CosminGeorge30/Stabilizator-de-tensiune-cu-element-de-reglaj-serie/poza_design_pcb.jpg

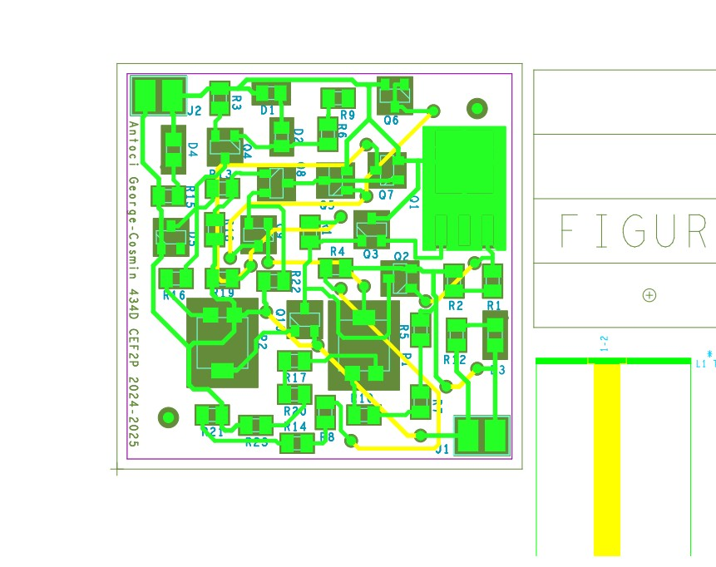
poza_design_pcb.jpg
