CosminGeorge30/Stabilizator-de-tensiune-cu-element-de-reglaj-serie/Simulations/top_pcb.jpg

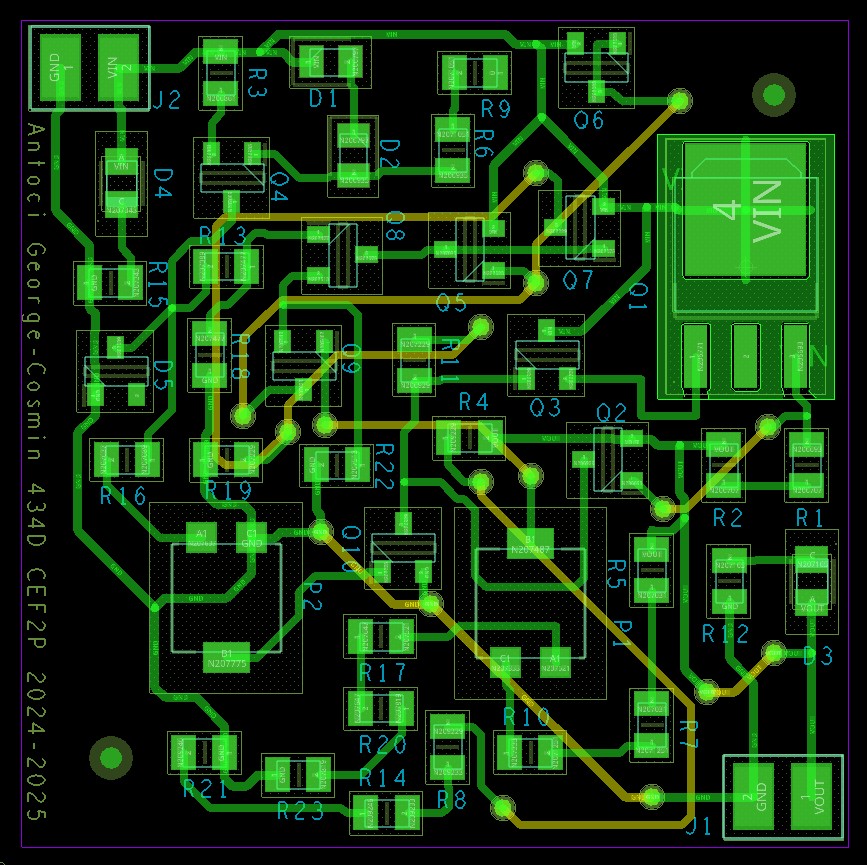
Simulations/top_pcb.jpg
