CosminGeorge30/Stabilizator-de-tensiune-cu-element-de-reglaj-serie/Proiect_docs/psf.pdf

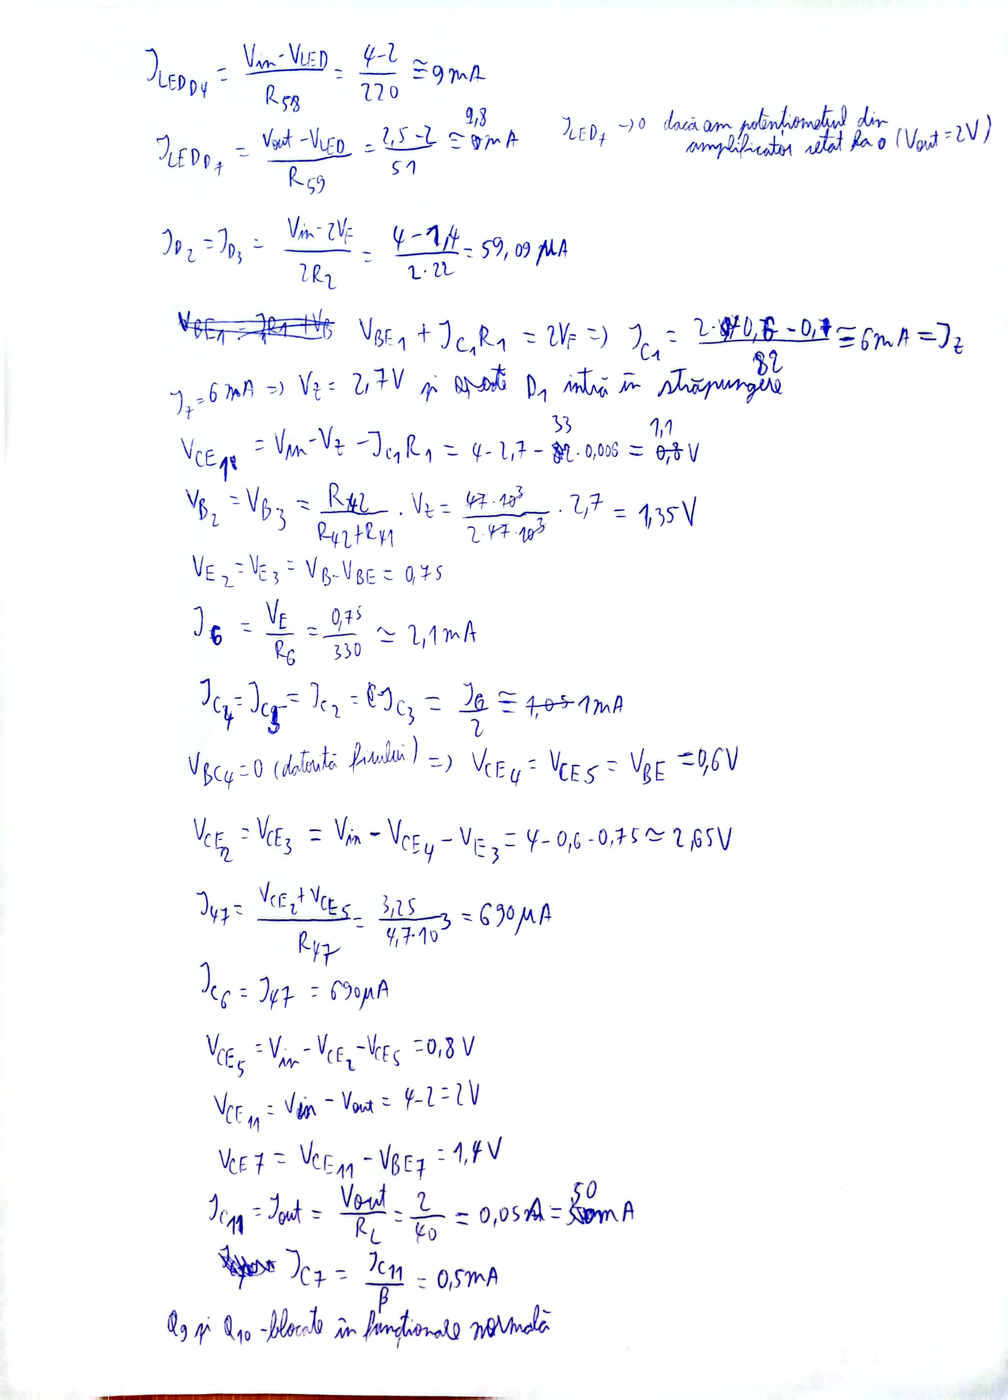
[picture p25: page 1]
