CosminGeorge30/Stabilizator-de-tensiune-cu-element-de-reglaj-serie/P1_Circuit_SERS/SERS_N1.png

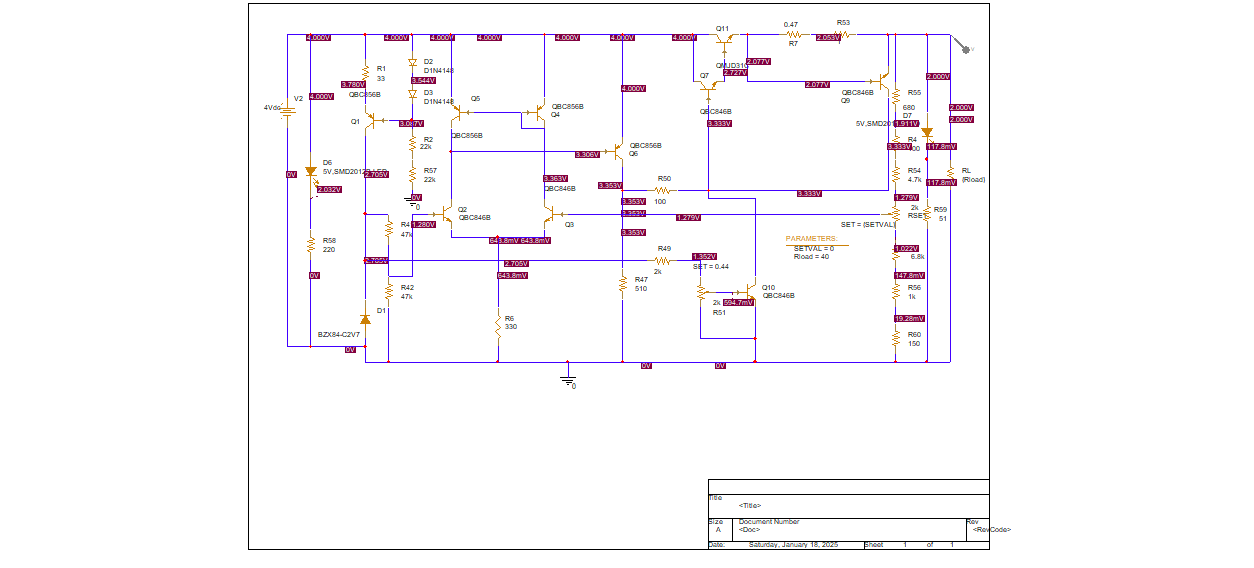
P1_Circuit_SERS/SERS_N1.png
