CosminGeorge30/Stabilizator-de-tensiune-cu-element-de-reglaj-serie/P1_Circuit_SERS_PCB/P1_PCB.png

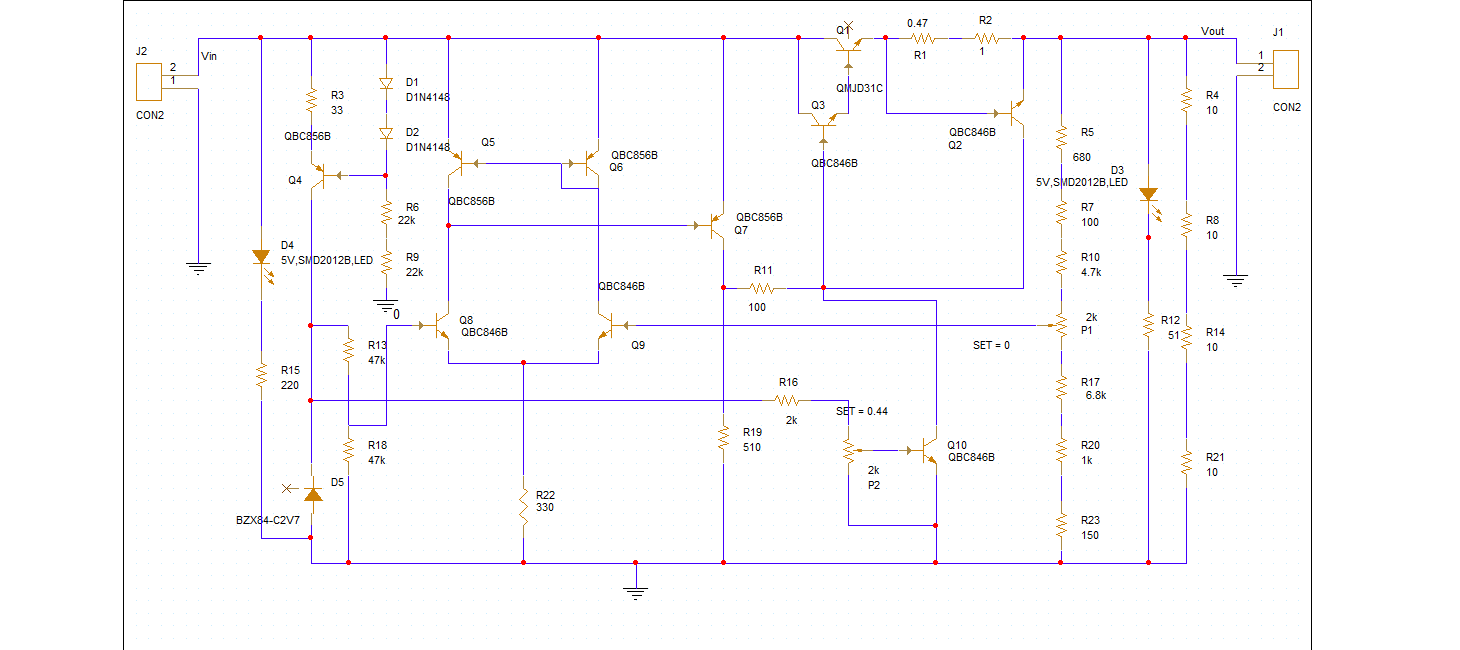
P1_Circuit_SERS_PCB/P1_PCB.png
