CosminGeorge30/Stabilizator-de-tensiune-cu-element-de-reglaj-serie/Schema_bloc.jpg

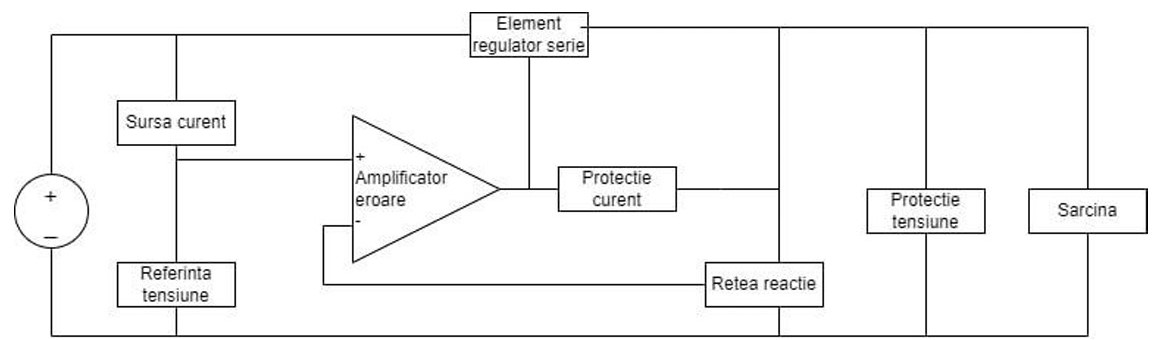
Schema_bloc.jpg
