CosminGeorge30/Stabilizator-de-tensiune-cu-element-de-reglaj-serie/Simulations/protectie_suprasarcina.jpg

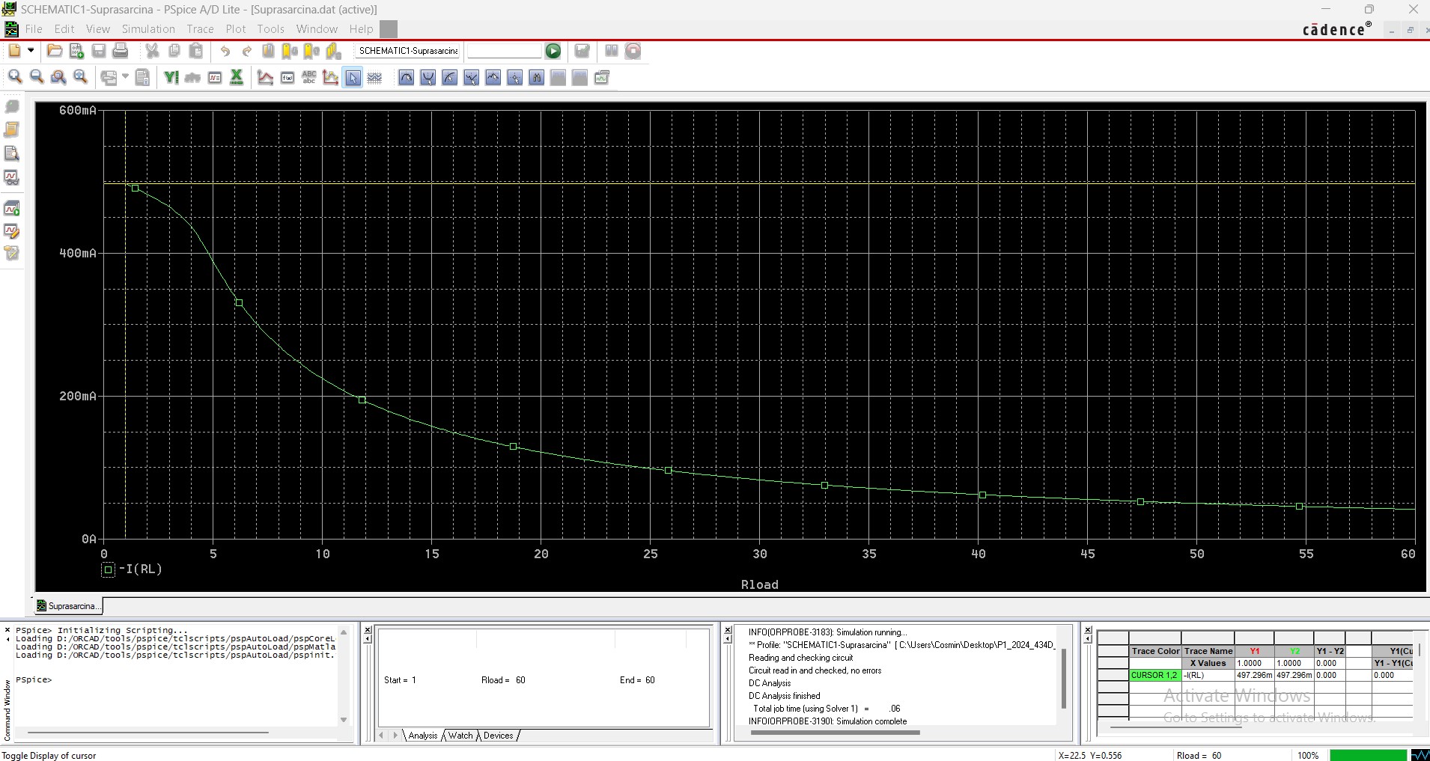
Simulations/protectie_suprasarcina.jpg
