CosminGeorge30/Stabilizator-de-tensiune-cu-element-de-reglaj-serie/Simulations/Vout_in_functie_de_set_potentiometru.jpg

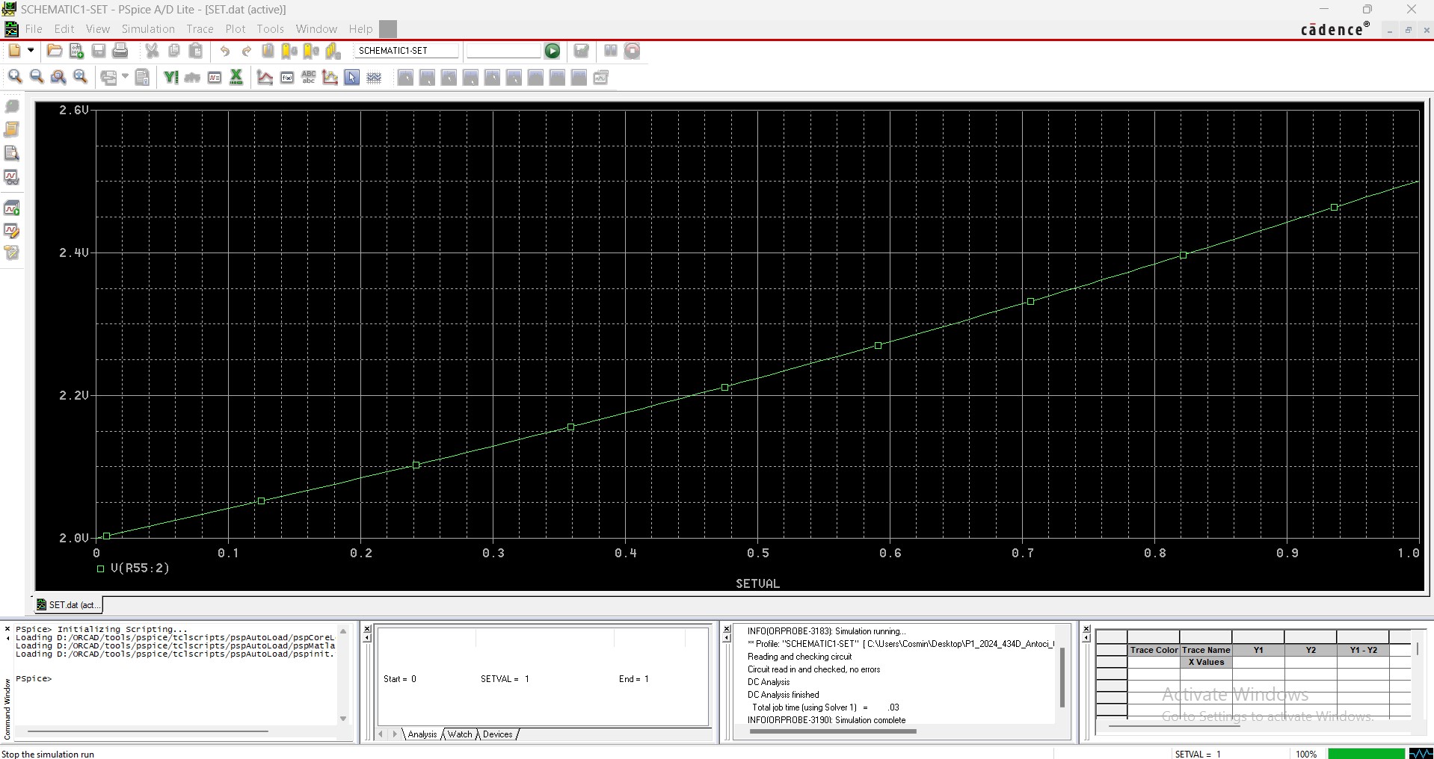
Simulations/Vout_in_functie_de_set_potentiometru.jpg
