CosminGeorge30/Stabilizator-de-tensiune-cu-element-de-reglaj-serie/Simulations/Vout_in_functie_de_Vin.jpg

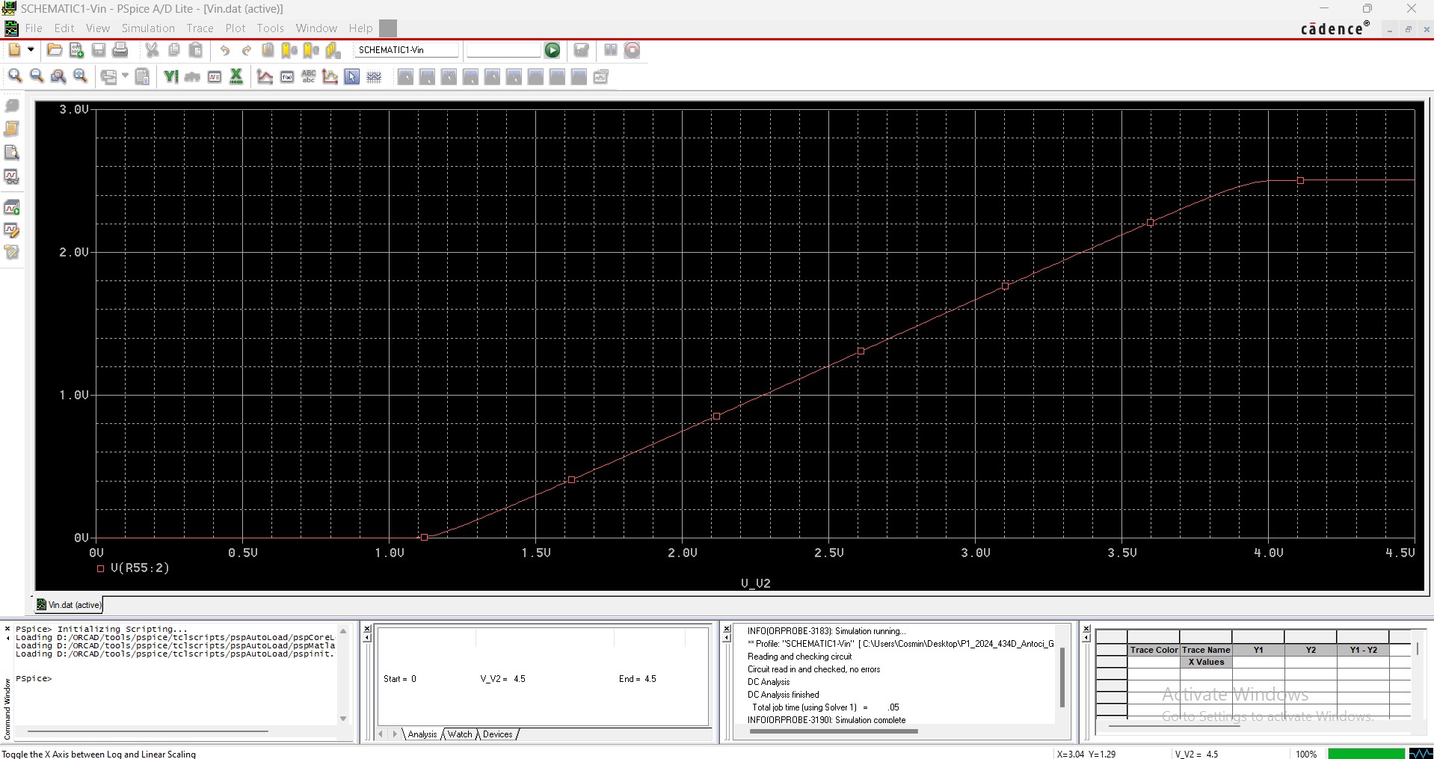
Simulations/Vout_in_functie_de_Vin.jpg
