CosminGeorge30/Stabilizator-de-tensiune-cu-element-de-reglaj-serie/P1_Circuit_SERS_PCB/ZL301-40P.stp

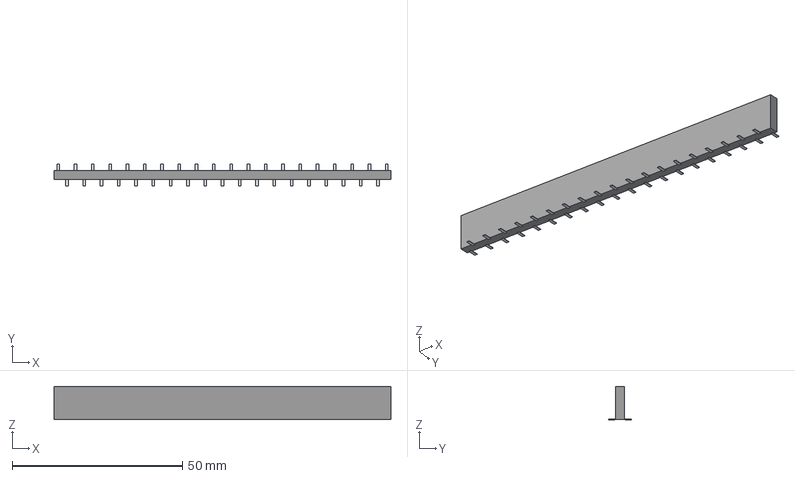
[picture p32: CAD file, 2025-03-30]
P1_Circuit_SERS_PCB/ZL301-40P.stp
99.1 x 6.50 x 9.80 mm
Pins
