CosminGeorge30/Stabilizator-de-tensiune-cu-element-de-reglaj-serie/P1_Circuit_SERS_PCB/CD4148WS_0805C_.stp

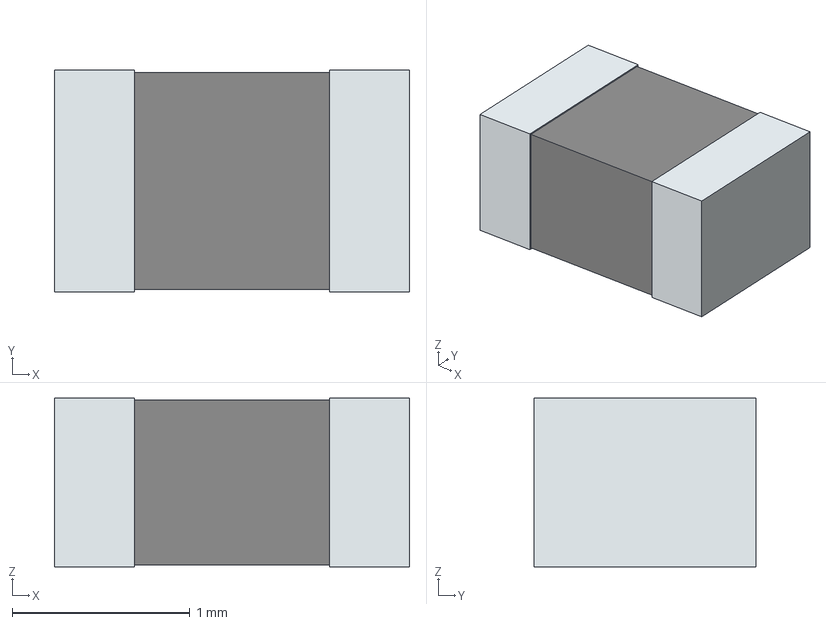
[picture p33: CAD file, 2025-03-30]
P1_Circuit_SERS_PCB/CD4148WS_0805C_.stp
2.00 x 1.25 x 0.95 mm
term1
term2
