CosminGeorge30/Stabilizator-de-tensiune-cu-element-de-reglaj-serie/P1_Circuit_SERS_PCB/res.stp

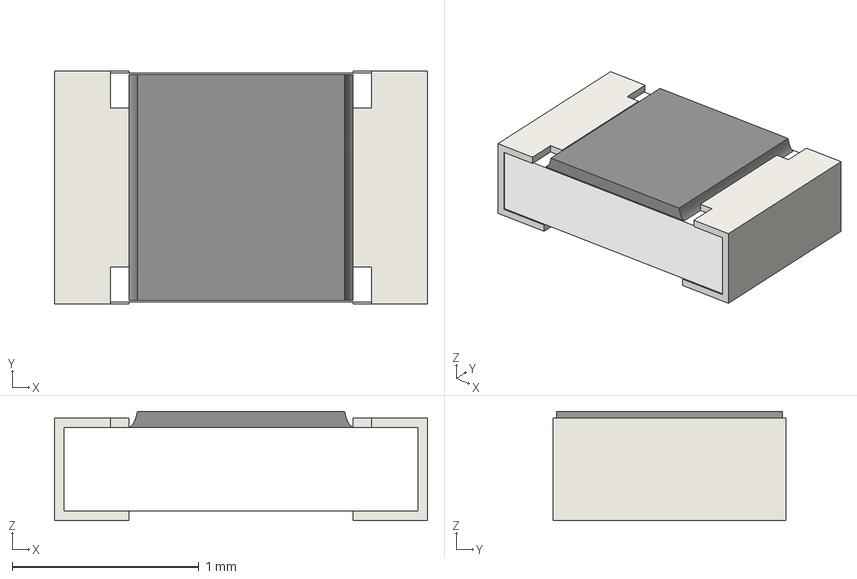
[picture p34: CAD file, 2025-03-30]
P1_Circuit_SERS_PCB/res.stp
2.00 x 1.25 x 0.585 mm
