CosminGeorge30/Stabilizator-de-tensiune-cu-element-de-reglaj-serie/P1_Circuit_SERS_PCB/BC846B.stp

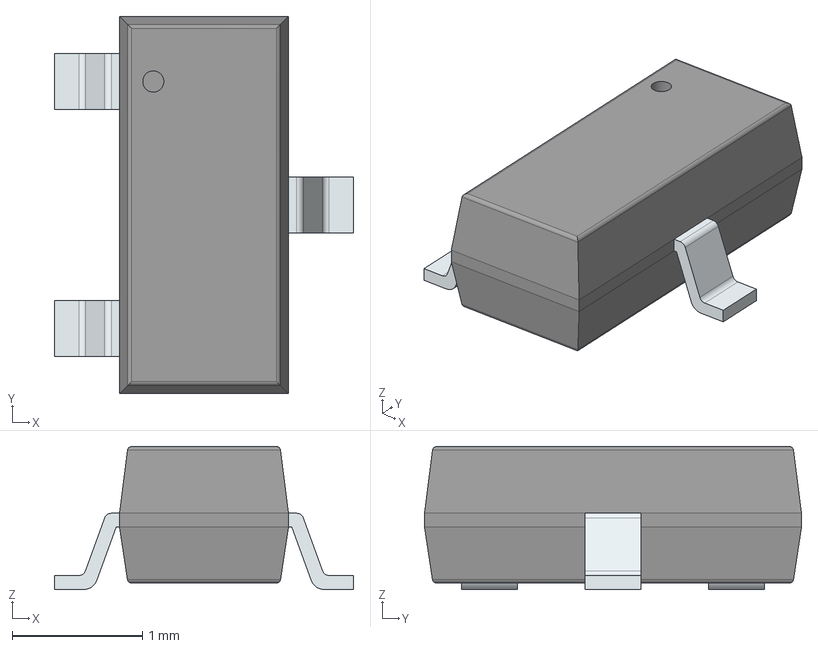
[picture p35: CAD file, 2025-03-30]
P1_Circuit_SERS_PCB/BC846B.stp
2.30 x 2.90 x 1.10 mm
PinsArrayL
FilletPinR
