CosminGeorge30/Stabilizator-de-tensiune-cu-element-de-reglaj-serie/P1_Circuit_SERS_PCB/3314G-1-103E.stp

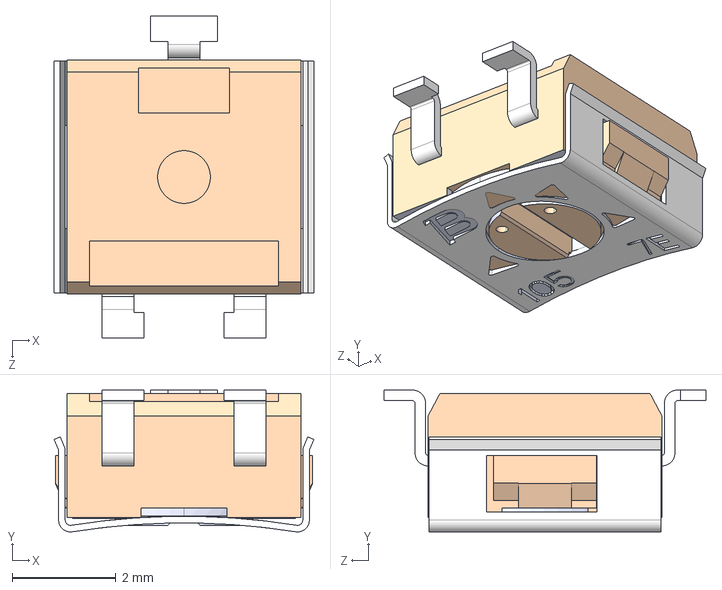
[picture p36: CAD file, 2025-03-30]
P1_Circuit_SERS_PCB/3314G-1-103E.stp
5.00 x 2.73 x 6.20 mm
