CosminGeorge30/Stabilizator-de-tensiune-cu-element-de-reglaj-serie/P1_Circuit_SERS_PCB/MJD31CG.stp

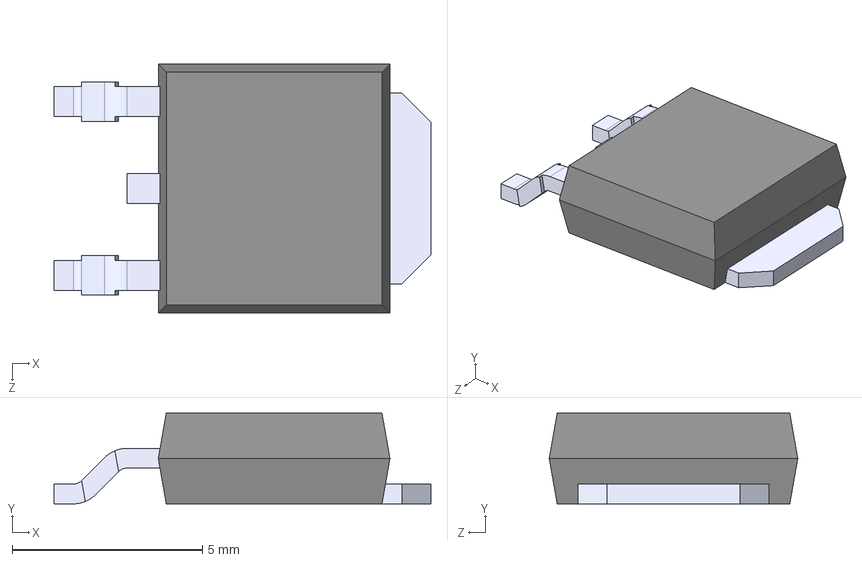
[picture p37: CAD file, 2025-03-30]
P1_Circuit_SERS_PCB/MJD31CG.stp
9.92 x 2.39 x 6.54 mm
MAC4DCMT4G_5
MAC4DCMT4G
MAC4DCMT4G_4
MAC4DCMT4G_3
MAC4DCMT4G_2
