CosminGeorge30/Stabilizator-de-tensiune-cu-element-de-reglaj-serie/P1_Circuit_SERS_PCB/OF-SMD2012B.stp

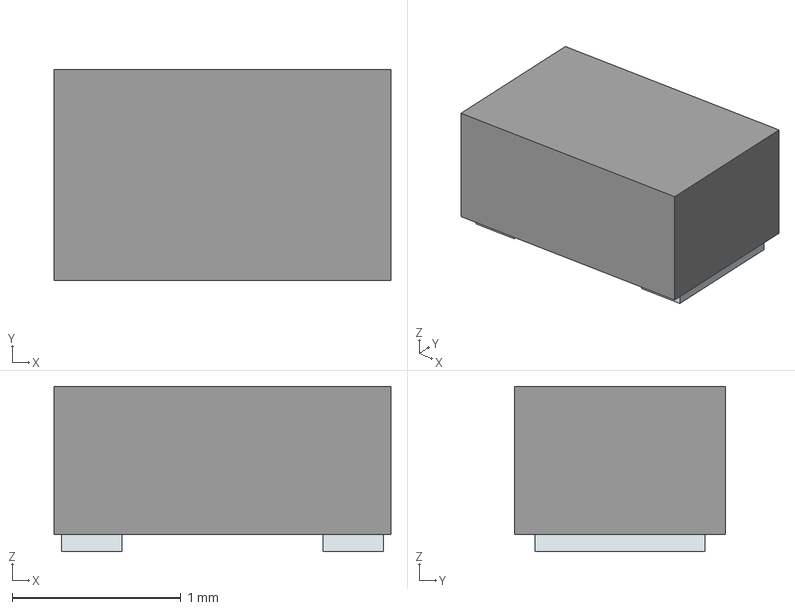
[picture p38: CAD file, 2025-03-30]
P1_Circuit_SERS_PCB/OF-SMD2012B.stp
2.00 x 1.25 x 0.98 mm
Pins
