CosminGeorge30/Stabilizator-de-tensiune-cu-element-de-reglaj-serie/P1_Circuit_SERS_PCB/TS53YL202MR10.stp

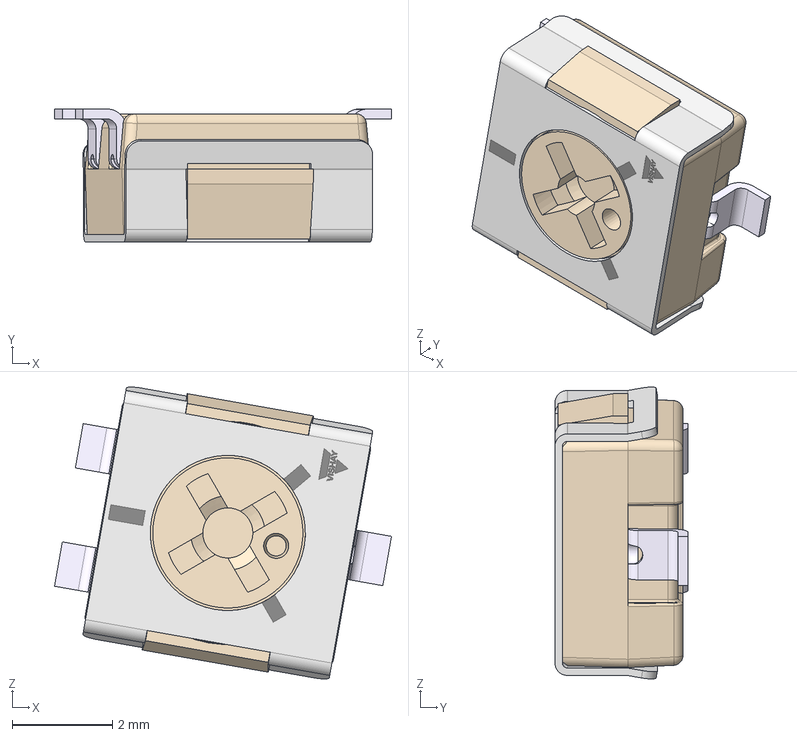
[picture p39: CAD file, 2025-03-30]
P1_Circuit_SERS_PCB/TS53YL202MR10.stp
6.73 x 2.66 x 5.83 mm
substrat seul
3935201-L
