CosminGeorge30/Stabilizator-de-tensiune-cu-element-de-reglaj-serie/(list of files, drawings)

Other design files:
Lib_ModelePSpice_Anexa_1/Modele_A1_lib/1N4148.OLB
Lib_ModelePSpice_Anexa_1/Modele_A1_lib/1n4148.opj
Lib_ModelePSpice_Anexa_1/Modele_A1_lib/BC807-25.OLB
Lib_ModelePSpice_Anexa_1/Modele_A1_lib/bc807-25.opj
Lib_ModelePSpice_Anexa_1/Modele_A1_lib/BC817-25.OLB
Lib_ModelePSpice_Anexa_1/Modele_A1_lib/bc817-25.opj
Lib_ModelePSpice_Anexa_1/Modele_A1_lib/BC846B.OLB
Lib_ModelePSpice_Anexa_1/Modele_A1_lib/BC856B.OLB
Lib_ModelePSpice_Anexa_1/Modele_A1_lib/BZX84C2V7.OLB
Lib_ModelePSpice_Anexa_1/Modele_A1_lib/BZX84C5V1.OLB
Lib_ModelePSpice_Anexa_1/Modele_A1_lib/BZX84C5V6.OLB
Lib_ModelePSpice_Anexa_1/Modele_A1_lib/BZX84C6V2.OLB
Lib_ModelePSpice_Anexa_1/Modele_A1_lib/BZX84C6V8.OLB
Lib_ModelePSpice_Anexa_1/Modele_A1_lib/BZX84C10.OLB
Lib_ModelePSpice_Anexa_1/Modele_A1_lib/IRFR120NPBF.OLB
Lib_ModelePSpice_Anexa_1/Modele_A1_lib/MJD31CG.OLB
Lib_ModelePSpice_Anexa_1/Modele_A1_lib/MJD32CG.OLB
Lib_ModelePSpice_Anexa_1/Modele_A1_lib/MMBFJ177LT1G.OLB
Lib_ModelePSpice_Anexa_1/Modele_A1_lib/MMBFJ309LT1G.OLB
P1_Circuit_SERS/SERS_N1.DSN
P1_Circuit_SERS/SERS_N1.opj
P1_Circuit_SERS/SIMULARE_BUCLA_DESCHISA.DSN
P1_Circuit_SERS/Simulare_Bucla_Deschisa.opj
P1_Circuit_SERS_PCB/P1_PCB.DSN
P1_Circuit_SERS_PCB/p1_pcb.opj
