CosminGeorge30/Stabilizator-de-tensiune-cu-element-de-reglaj-serie/P1_Circuit_SERS_PCB/allegro/nc_param.txt

INTEGER-PLACES         2
DECIMAL-PLACES         5
X-OFFSET               0.000000
Y-OFFSET               0.000000
FEEDRATE               1
COORDINATES            ABSOLUTE
OUTPUT-UNITS           ENGLISH
TOOL-ORDER             INCREASING
REPEAT-CODES           YES
SUPPRESS-LEAD-ZEROES   YES
SUPPRESS-TRAIL-ZEROES  NO
SUPPRESS-EQUAL         NO
TOOL-SELECT            YES
OPTIMIZE_DRILLING      NO
ENHANCED_EXCELLON      YES
HEADER                 none
LEADER                 12
CODE                   ASCII
SEPARATE               NO
SEPARATE-ROUTING       NO
DRILLING               LAYER-PAIR
BACKDRILL              NO
CAVITY                 NO
COUNTER                NO
TOLERANCE_DRILL        YES
TOLERANCE_TRAVEL       YES
TOOL_SIZE              NO
ROTATION               YES
NON_STANDARD           YES
TOTAL_DRILL            NO
SEPARATE_SLOT          NO
SUPPRESS_TOLERANCE     YES
SUPPRESS_TOOLSIZE      YES
SUPPRESS_ROTATION      YES
